stansca/f500-avionica/avionica_f500_v2/_revA_antiga/docs/pcb_top.png

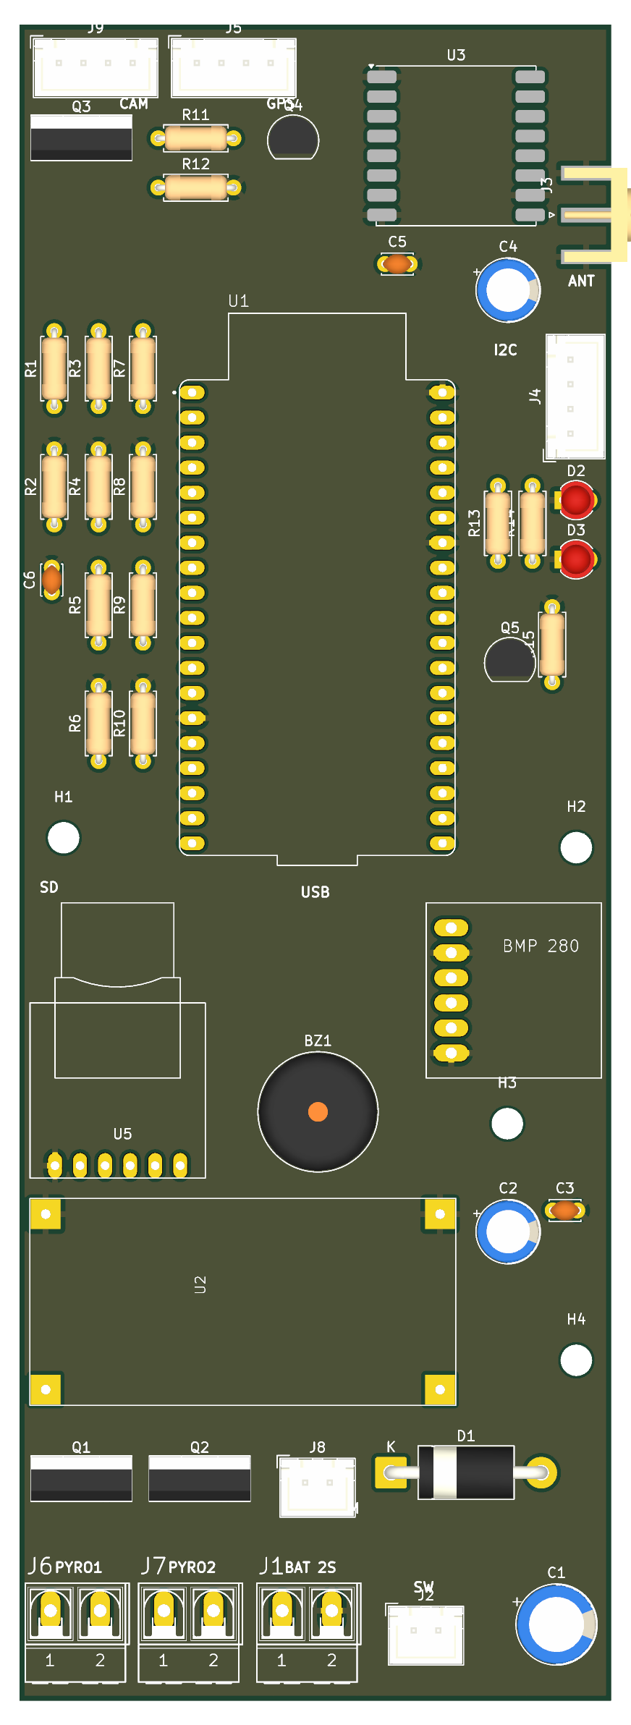
avionica_f500_v2/_revA_antiga/docs/pcb_top.png
