stansca/f500-avionica/avionica_f500_v2_sem_video/docs/pcb_bottom.png

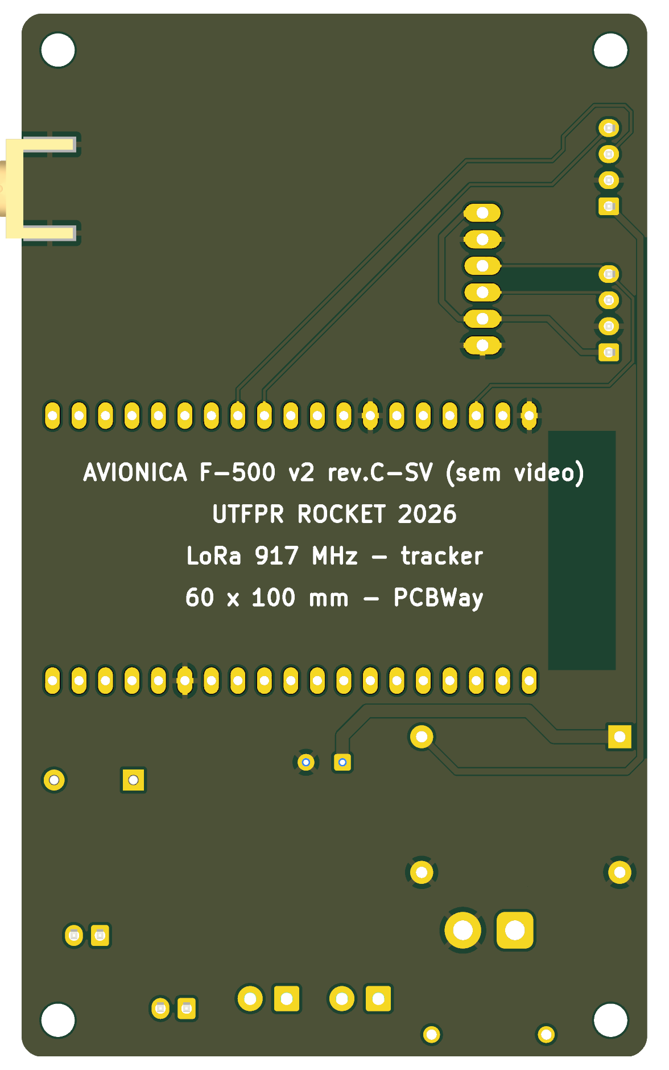
avionica_f500_v2_sem_video/docs/pcb_bottom.png
