stansca/f500-avionica/avionica_f500_v2/docs/BOM.csv

Reference | Value | Footprint | QUANTITY
BZ1 | Buzzer ativo 5V | Buzzer_Beeper:Buzzer_12x9.5RM7.6 | 1
C1 | 470uF 16V | Capacitor_THT:CP_Radial_D8.0mm_P3.50mm | 1
C2 | 10uF 25V | Capacitor_SMD:C_1206_3216Metric_Pad1.33x1.80mm_HandSolder | 1
C3 | 10uF | Capacitor_SMD:C_1206_3216Metric_Pad1.33x1.80mm_HandSolder | 1
C4-C7,C9,C11,C12,C14,C16 | 100nF | Capacitor_SMD:C_0805_2012Metric_Pad1.18x1.45mm_HandSolder | 9
C8,C13,C15 | 10uF | Capacitor_SMD:C_0805_2012Metric_Pad1.18x1.45mm_HandSolder | 3
C10 | 100uF 16V | Capacitor_SMD:CP_Elec_6.3x7.7 | 1
D1 | SS34 | Diode_SMD:D_SMA_Handsoldering | 1
D2 | LED verde | LED_SMD:LED_0805_2012Metric_Pad1.15x1.40mm_HandSolder | 1
D3 | LED vermelho | LED_SMD:LED_0805_2012Metric_Pad1.15x1.40mm_HandSolder | 1
J1 | XT30 BATERIA 2S | Connector_AMASS:AMASS_XT30PW-M_1x02_P2.50mm_Horizontal | 1
J2 | CHAVE PRINCIPAL | Connector_JST:JST_XH_B2B-XH-A_1x02_P2.50mm_Vertical | 1
J3 | SMA 50R | Connector_Coaxial:SMA_Amphenol_132289_EdgeMount | 1
J4 | CAMERA / VTX | Connector_JST:JST_XH_B4B-XH-A_1x04_P2.50mm_Vertical | 1
J5 | I2C / IMU extra | Connector_JST:JST_XH_B4B-XH-A_1x04_P2.50mm_Vertical | 1
J6 | GPS NEO-M8N (cabo) | Connector_JST:JST_XH_B4B-XH-A_1x04_P2.50mm_Vertical | 1
J7 | microSD Molex 104031 | Connector_Card:microSD_HC_Molex_104031-0811 | 1
J8 | CHAVE DE ARME | Connector_JST:JST_XH_B2B-XH-A_1x02_P2.50mm_Vertical | 1
J9 | PYRO 1 (apogeu) | TerminalBlock_Phoenix:TerminalBlock_Phoenix_PT-1,5-2-3.5-H_1x02_P3.50mm_Horizontal | 1
J10 | PYRO 2 (backup) | TerminalBlock_Phoenix:TerminalBlock_Phoenix_PT-1,5-2-3.5-H_1x02_P3.50mm_Horizontal | 1
Q1,Q2,Q4,Q5 | AO3400A | Package_TO_SOT_SMD:SOT-23 | 4
Q3 | AO3401A | Package_TO_SOT_SMD:SOT-23 | 1
R1,R11,R15 | 100k | Resistor_SMD:R_0805_2012Metric_Pad1.20x1.40mm_HandSolder | 3
R2,R12,R16 | 22k | Resistor_SMD:R_0805_2012Metric_Pad1.20x1.40mm_HandSolder | 3
R3-R8,R10,R14,R19 | 10k | Resistor_SMD:R_0805_2012Metric_Pad1.20x1.40mm_HandSolder | 9
R9,R13 | 100 | Resistor_SMD:R_0805_2012Metric_Pad1.20x1.40mm_HandSolder | 2
R17,R18 | 330 | Resistor_SMD:R_0805_2012Metric_Pad1.20x1.40mm_HandSolder | 2
U1 | ESP32-DevKitC-32E | JS_Microcontroladores:ESP32-DevKitC-32E | 1
U2 | MP1584EN 5V 3A | F500v2:MP1584_Modulo | 1
U3 | RFM95W 915 MHz | RF_Module:HOPERF_RFM9XW_SMD | 1
U4 | BMP280 (0x76) | JS_Sensores:BMP280_Modulo | 1
