stansca/f500-avionica/avionica_f500_v2/_revA_antiga/docs/BOM.csv

Reference | Value | Footprint | QUANTITY
BZ1 | Buzzer ativo 5V | Buzzer_Beeper:Buzzer_12x9.5RM7.6 | 1
C1 | 470uF 16V | Capacitor_THT:CP_Radial_D8.0mm_P3.50mm | 1
C2,C4 | 100uF 10V | Capacitor_THT:CP_Radial_D6.3mm_P2.50mm | 2
C3,C5,C6 | 100nF | Capacitor_THT:C_Disc_D3.0mm_W2.0mm_P2.50mm | 3
D1 | 1N5822 | Diode_THT:D_DO-201AD_P15.24mm_Horizontal | 1
D2 | LED verde | LED_THT:LED_D3.0mm | 1
D3 | LED vermelho | LED_THT:LED_D3.0mm | 1
J1 | BATERIA 2S (7,4 V) | JS_Conectores:Borne_AK500-2 | 1
J2 | CHAVE_PRINCIPAL | Connector_JST:JST_XH_B2B-XH-A_1x02_P2.50mm_Vertical | 1
J3 | SMA antena 915 MHz | Connector_Coaxial:SMA_Amphenol_132289_EdgeMount | 1
J4 | I2C / IMU extra | Connector_JST:JST_XH_B4B-XH-A_1x04_P2.50mm_Vertical | 1
J5 | GPS NEO-M8N (cabo) | Connector_JST:JST_XH_B4B-XH-A_1x04_P2.50mm_Vertical | 1
J6 | PYRO 1 (apogeu) | JS_Conectores:Borne_AK500-2 | 1
J7 | PYRO 2 (backup) | JS_Conectores:Borne_AK500-2 | 1
J8 | CHAVE_ARME | Connector_JST:JST_XH_B2B-XH-A_1x02_P2.50mm_Vertical | 1
J9 | CAMERA / VTX (DJI O4 / Walksnail) | Connector_JST:JST_XH_B4B-XH-A_1x04_P2.50mm_Vertical | 1
Q1,Q2 | IRLZ44N | Package_TO_SOT_THT:TO-220-3_Vertical | 2
Q3 | IRF9540N | Package_TO_SOT_THT:TO-220-3_Vertical | 1
Q4,Q5 | 2N7000 | Package_TO_SOT_THT:TO-92_Inline | 2
R1,R5,R9 | 100k | Resistor_THT:R_Axial_DIN0207_L6.3mm_D2.5mm_P7.62mm_Horizontal | 3
R2,R6,R10 | 22k | Resistor_THT:R_Axial_DIN0207_L6.3mm_D2.5mm_P7.62mm_Horizontal | 3
R3,R7 | 100 | Resistor_THT:R_Axial_DIN0207_L6.3mm_D2.5mm_P7.62mm_Horizontal | 2
R4,R8,R11,R12,R15 | 10k | Resistor_THT:R_Axial_DIN0207_L6.3mm_D2.5mm_P7.62mm_Horizontal | 5
R13,R14 | 330 | Resistor_THT:R_Axial_DIN0207_L6.3mm_D2.5mm_P7.62mm_Horizontal | 2
U1 | ESP32-DevKitC-32E | JS_Microcontroladores:ESP32-DevKitC-32E | 1
U2 | Buck LM2596 -> 5V | JS_Energia:Buck_Conversor | 1
U3 | RFM95W 915 MHz | RF_Module:HOPERF_RFM9XW_SMD | 1
U4 | BMP280 (0x76) | JS_Sensores:BMP280_Modulo | 1
U5 | Cartão microSD | JS_Modulos:SD_Card_Adapter | 1
