stansca/f500-avionica/avionica_f500_v2/docs/esquematico.pdf

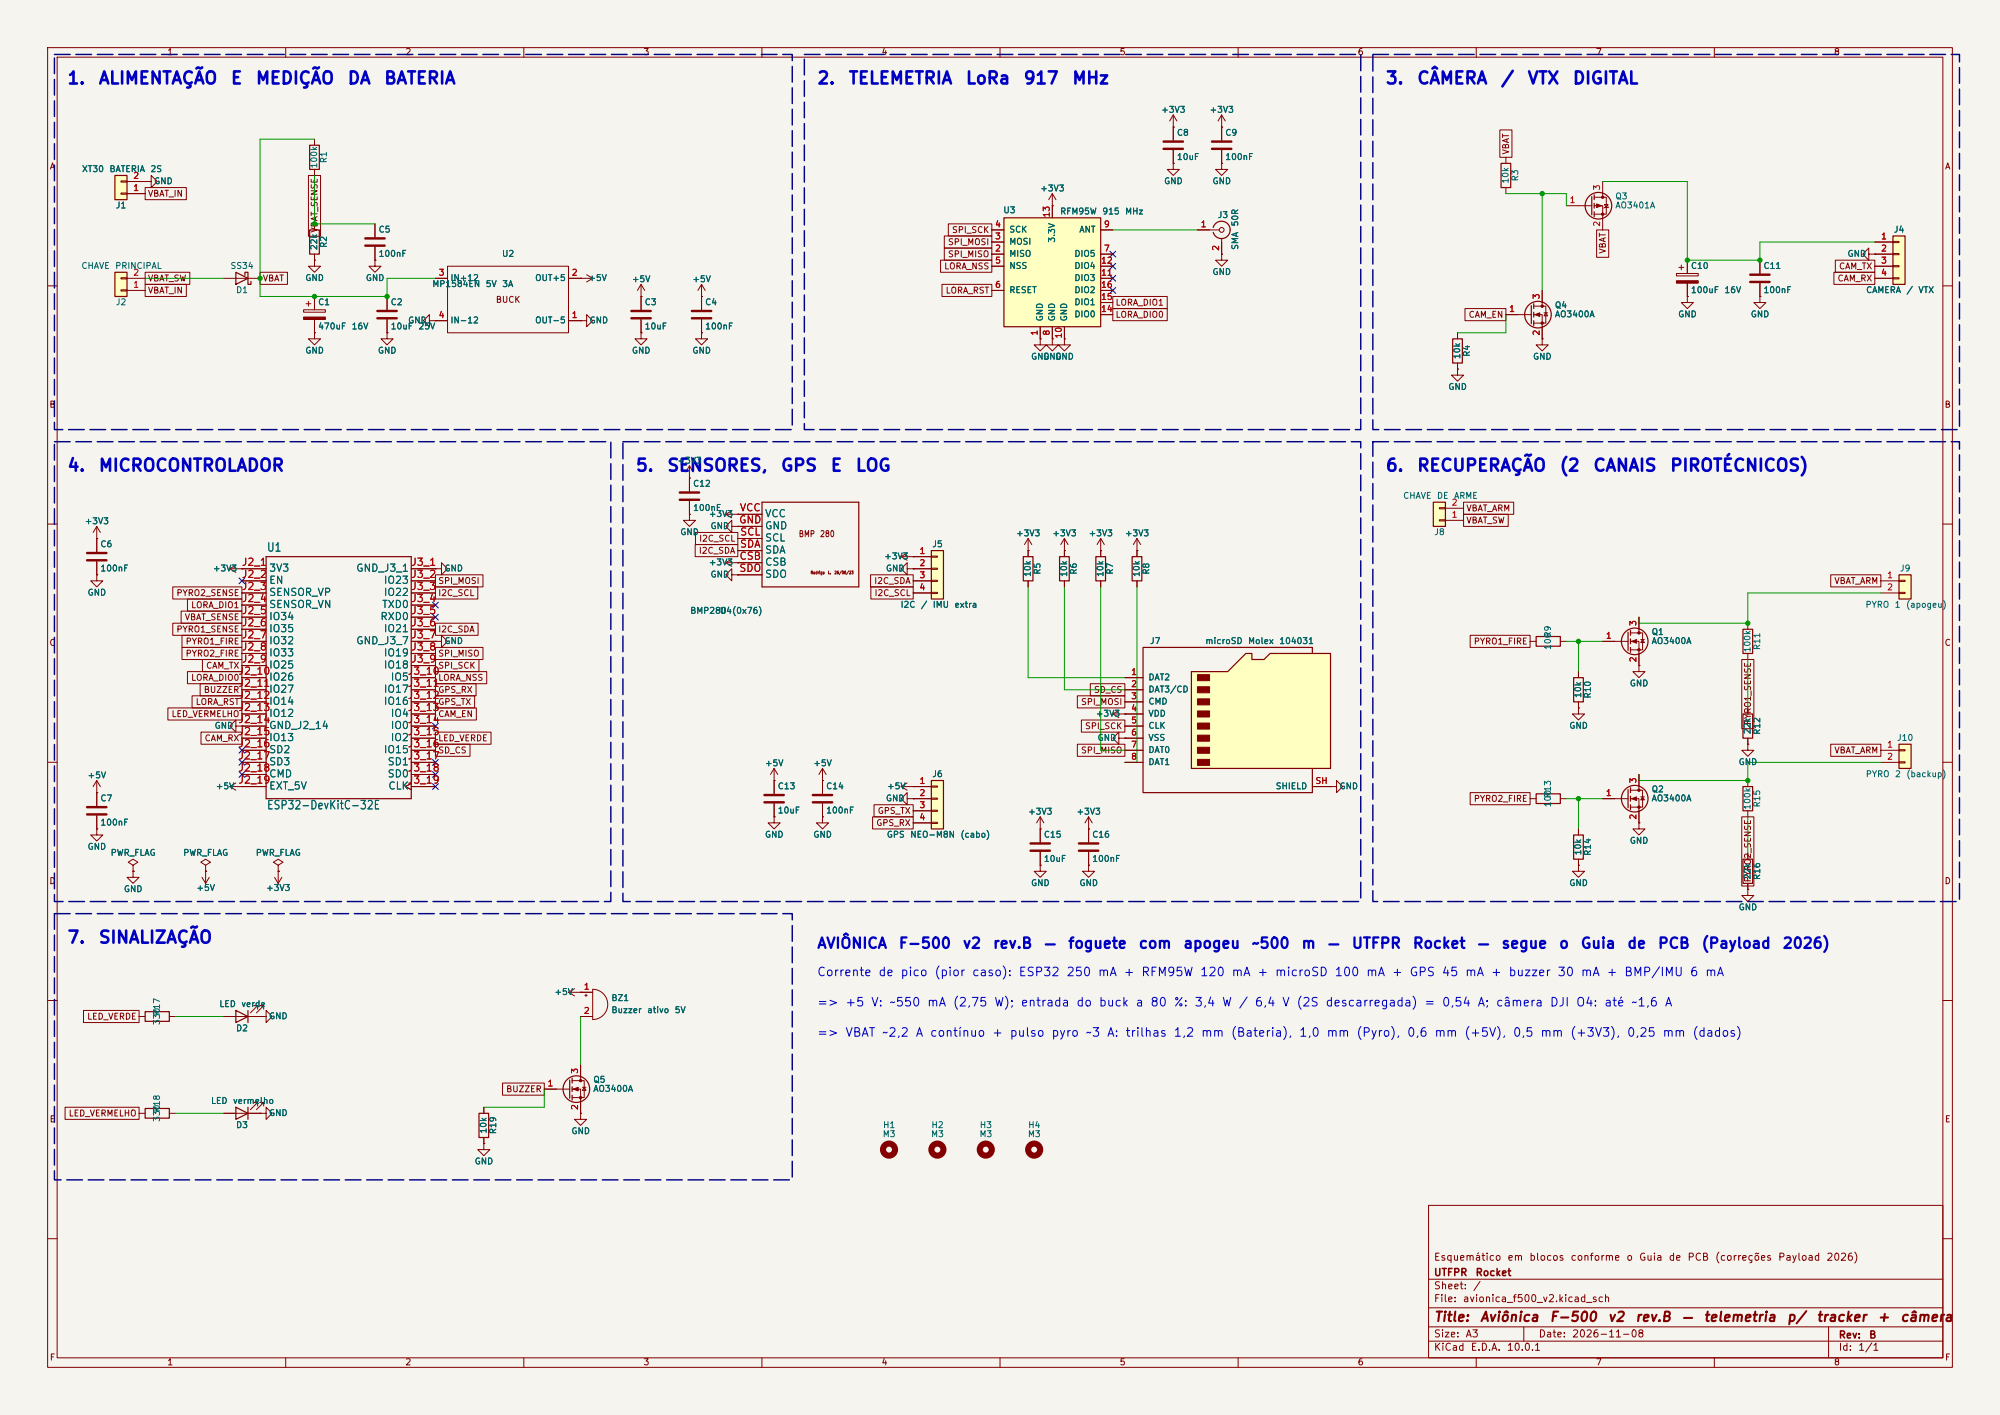
[picture p16: page 1]

6. RECUPERAÇÃO (2 CANAIS PIROTÉCNICOS) => VBAT ~2,2 A contínuo + pulso pyro ~3 A: trilhas 1,2 mm (Bateria), 1,0 mm (Pyro), 0,6 mm (+5V), 0,5 mm (+3V3), 0,25 mm (dados) => +5 V: ~550 mA (2,75 W); entrada do buck a 80 %: 3,4 W / 6,4 V (2S descarregada) = 0,54 A; câmera DJI O4: até ~1,6 A

AVIÔNICA F-500 v2 rev.B — foguete com apogeu ~500 m — UTFPR Rocket — segue o Guia de PCB (Payload 2026)

Corrente de pico (pior caso): ESP32 250 mA + RFM95W 120 mA + microSD 100 mA + GPS 45 mA + buzzer 30 mA + BMP/IMU 6 mA

Esquemático em blocos conforme o Guia de PCB (correções Payload 2026)
UTFPR Rocket
Sheet: /
File: avionica_f500_v2.kicad_sch
Title: Aviônica F-500 v2 rev.B — telemetria p/ tracker + câmera

Size: A3 | Rev: B | F Date: 2026-11-08
KiCad E.D.A. 10.0.1 | Id: 1/1
