stansca/f500-avionica/avionica_f500_v2_sem_video/docs/esquematico.pdf

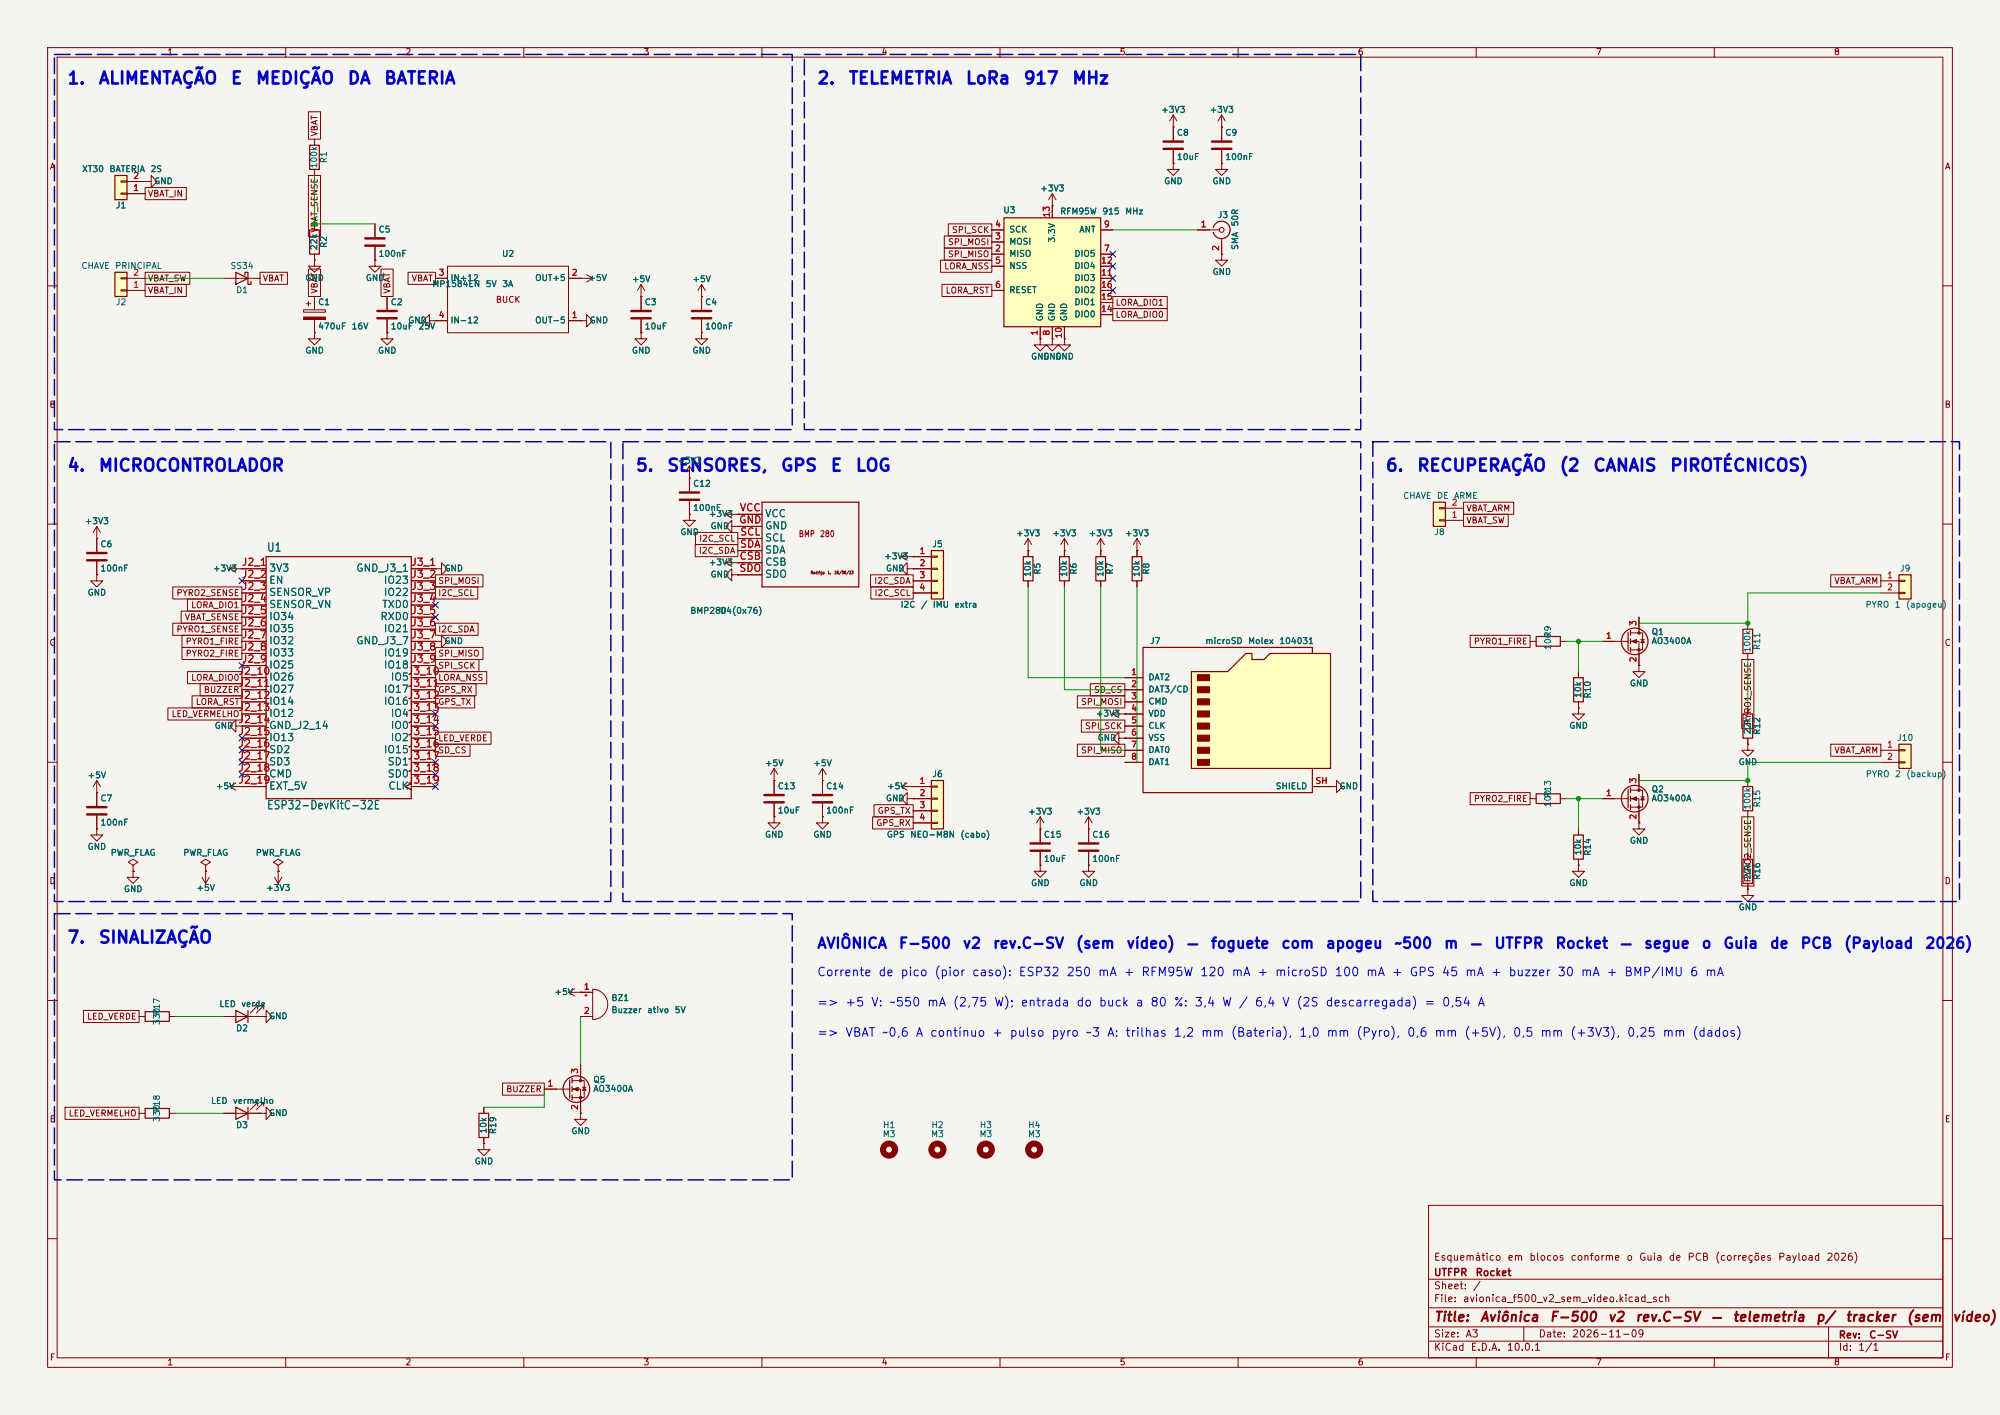
[picture p17: page 1]

1. ALIMENTAÇÃO E MEDIÇÃO DA BATERIA

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

Esquemático em blocos conforme o Guia de PCB (correções Payload 2026)
UTFPR Rocket
Sheet: /
File: avionica_f500_v2_sem_video.kicad_sch

Size: A3 | Rev: C-SV | F Date: 2026-11-09
KiCad E.D.A. 10.0.1 | Id: 1/1
