stansca/f500-avionica/avionica_f500_v2_video/docs/esquematico.pdf

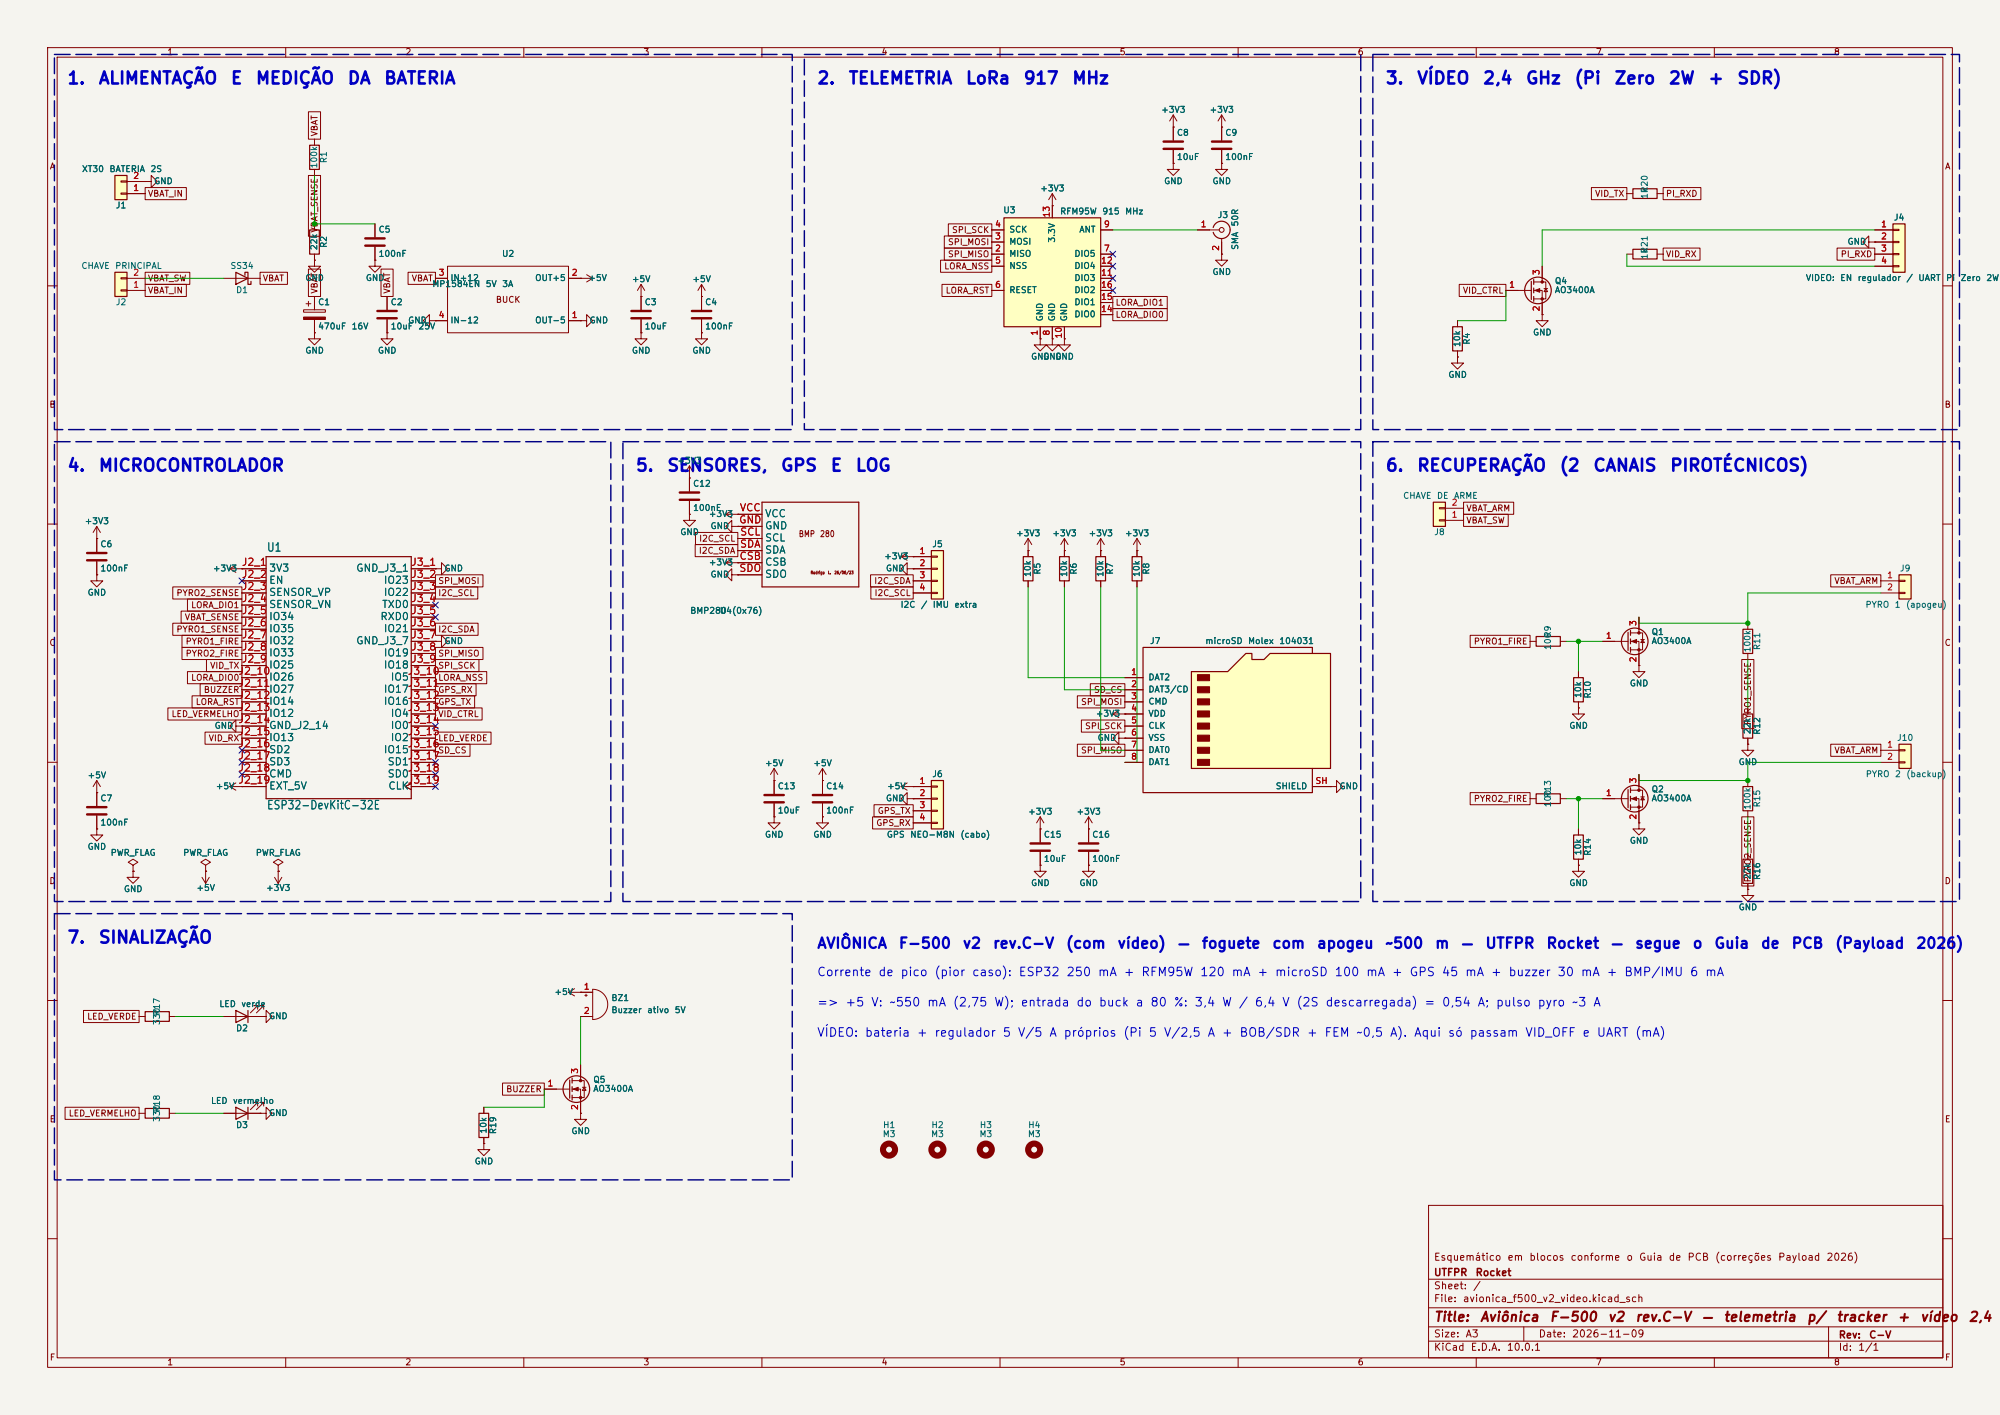
[picture p18: page 1]

1. ALIMENTAÇÃO E MEDIÇÃO DA BATERIA

3. VÍDEO 2,4 GHz (Pi Zero 2W + SDR)
Esquemático em blocos conforme o Guia de PCB (correções Payload 2026) R20 1k

AVIÔNICA F-500 v2 rev.C-V (com vídeo) — foguete com apogeu ~500 m — UTFPR Rocket — segue o Guia de PCB (Payload 2026)

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

VÍDEO: bateria + regulador 5 V/5 A próprios (Pi 5 V/2,5 A + BOB/SDR + FEM ~0,5 A). Aqui só passam VID_OFF e UART (mA) => +5 V: ~550 mA (2,75 W); entrada do buck a 80 %: 3,4 W / 6,4 V (2S descarregada) = 0,54 A; pulso pyro ~3 A

UTFPR Rocket
Sheet: /
File: avionica_f500_v2_video.kicad_sch
Title: Aviônica F-500 v2 rev.C-V — telemetria p/ tracker + vídeo 2,4 GHz

Size: A3 | Rev: C-V | F Date: 2026-11-09
KiCad E.D.A. 10.0.1 | Id: 1/1
