stansca/f500-avionica/avionica_f500_v2/_revA_antiga/docs/esquematico.pdf

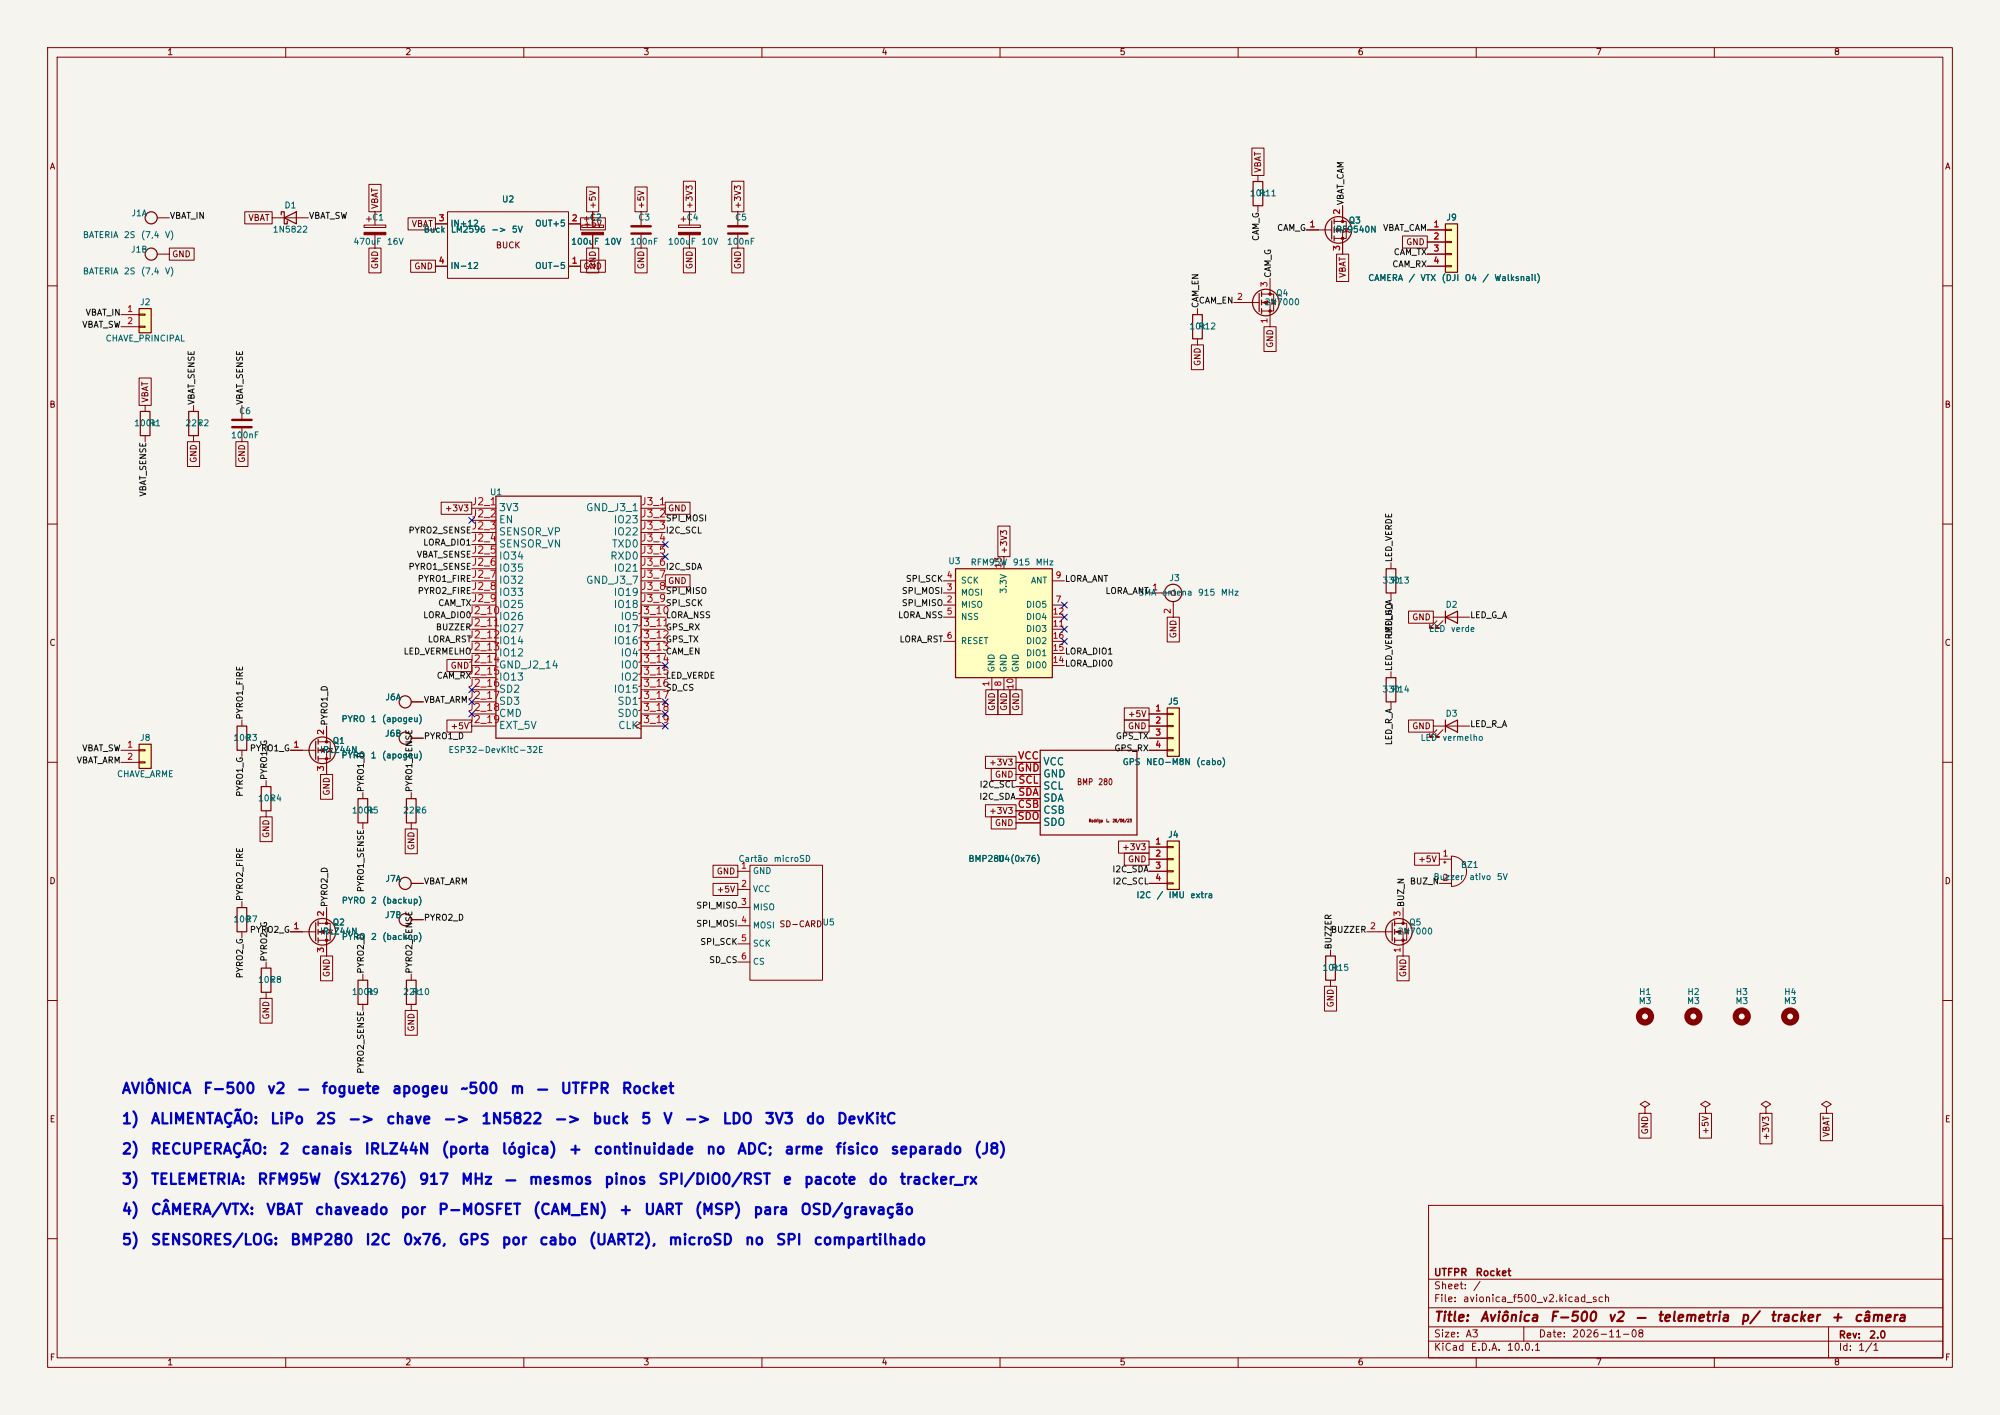
[picture p19: page 1]

J9 CAMERA / VTX (DJI O4 / Walksnail) 1
VBAT_CAM

AVIÔNICA F-500 v2 — foguete apogeu ~500 m — UTFPR Rocket
1) ALIMENTAÇÃO: LiPo 2S -> chave -> 1N5822 -> buck 5 V -> LDO 3V3 do DevKitC
2) RECUPERAÇÃO: 2 canais IRLZ44N (porta lógica) + continuidade no ADC; arme físico separado (J8)

3) TELEMETRIA: RFM95W (SX1276) 917 MHz — mesmos pinos SPI/DIO0/RST e pacote do tracker_rx
4) CÂMERA/VTX: VBAT chaveado por P-MOSFET (CAM_EN) + UART (MSP) para OSD/gravação

5) SENSORES/LOG: BMP280 I2C 0x76, GPS por cabo (UART2), microSD no SPI compartilhado

UTFPR Rocket
Sheet: /
File: avionica_f500_v2.kicad_sch
Title: Aviônica F-500 v2 — telemetria p/ tracker + câmera

Size: A3 | Rev: 2.0 | F Date: 2026-11-08
KiCad E.D.A. 10.0.1 | Id: 1/1
