stansca/f500-avionica/avionica_f500_v2_video/avionica_f500_v2_video.kicad_pcb

## KiCad design avionica_f500_v2_video/avionica_f500_v2_video.kicad_pcb (2026-11-14)

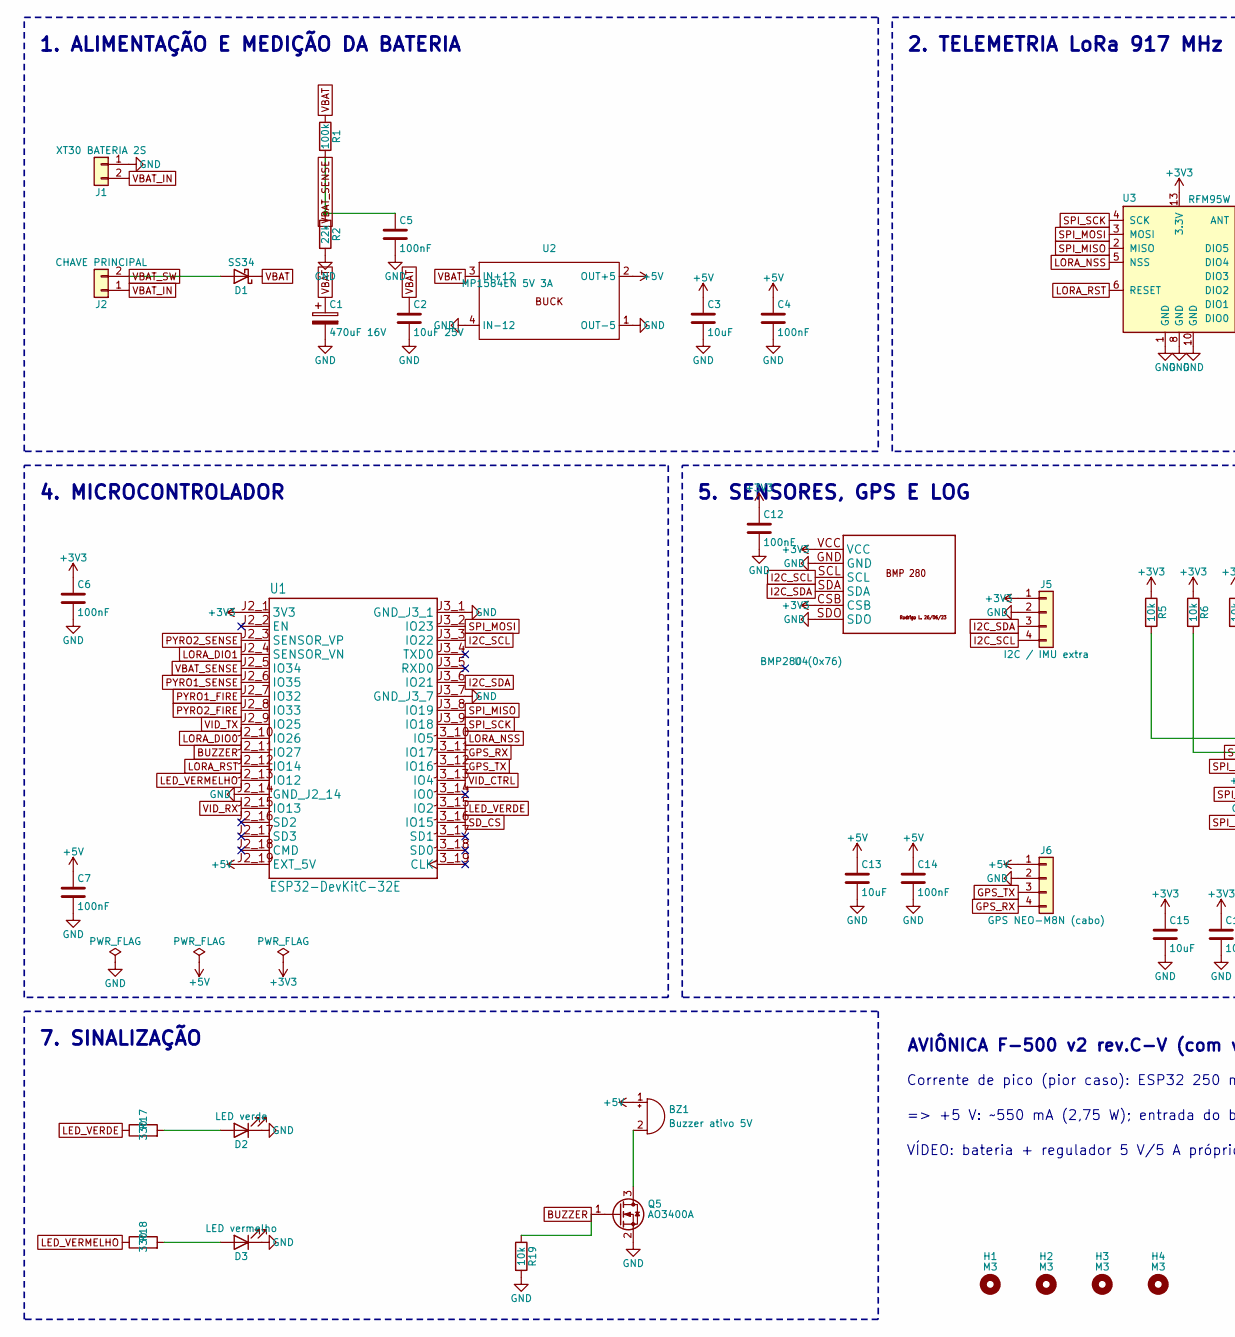
[picture p20: schematic avionica_f500_v2_video.kicad_sch, Aviônica F-500 v2 rev.C-V — telemetria p/ tracker + vídeo 2…, part in row 1, column 1]

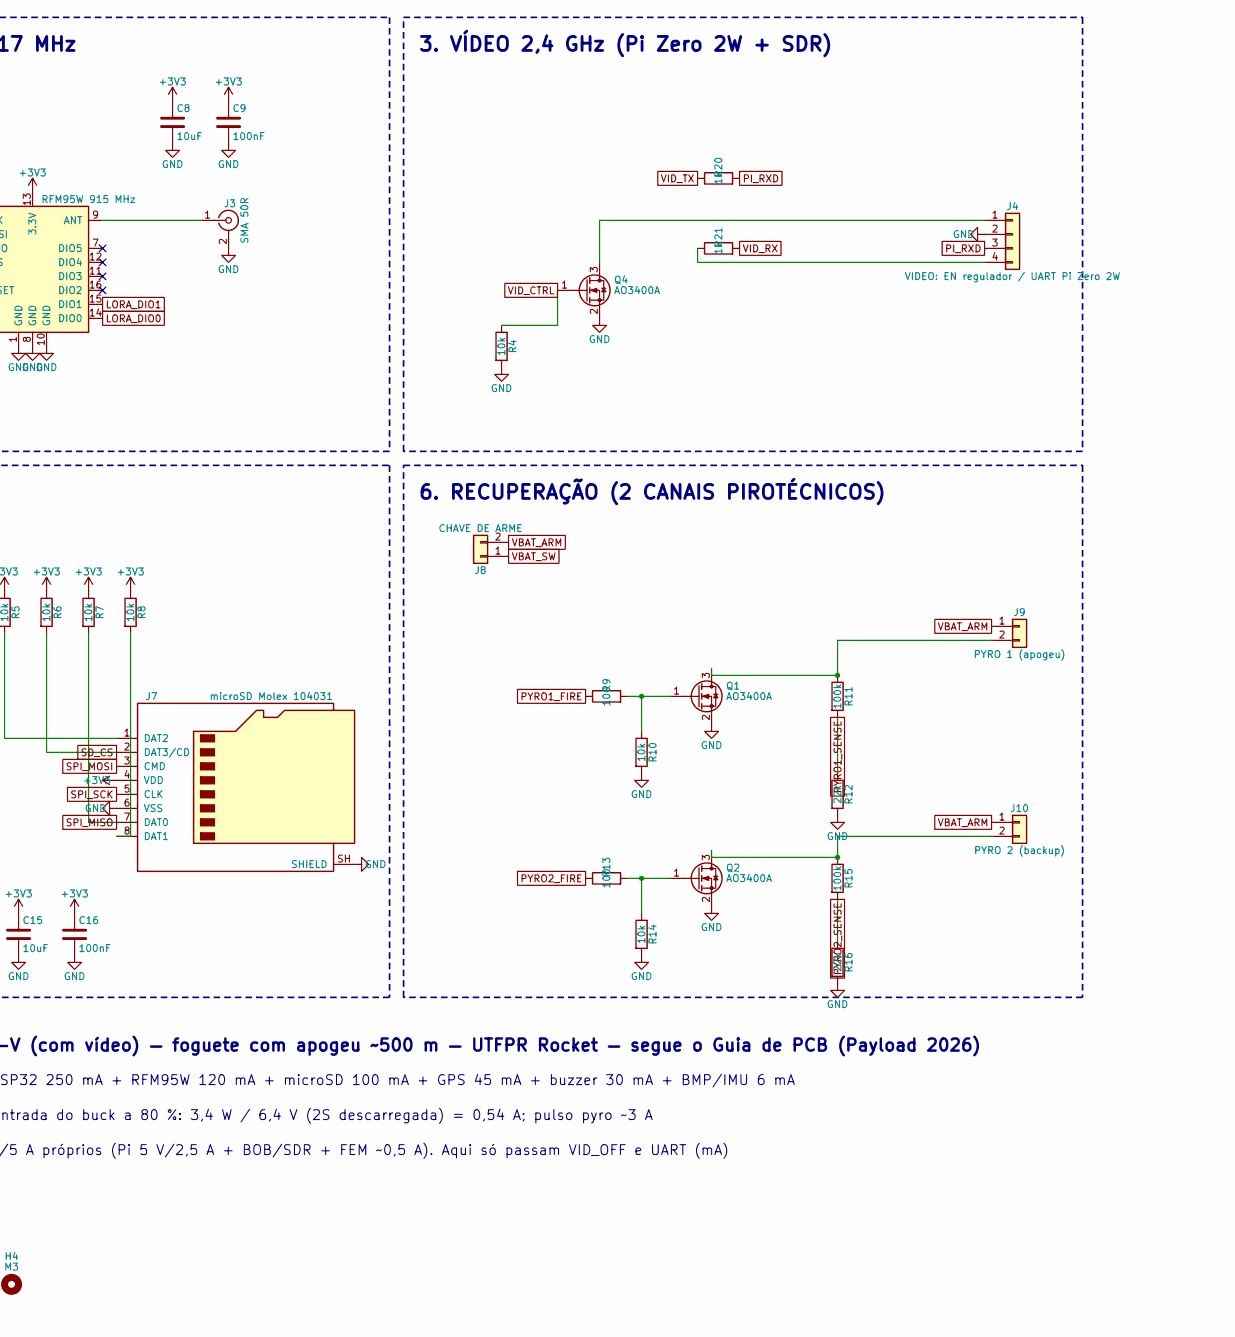
[picture p21: schematic avionica_f500_v2_video.kicad_sch, Aviônica F-500 v2 rev.C-V — telemetria p/ tracker + vídeo 2…, part in row 1, column 2]

Parts:
BZ1: Buzzer ativo 5V; Buzzer_12x9.5RM7.6
C1: 470uF 16V; CP_Radial_D8.0mm_P3.50mm
C2: 10uF 25V; C_1206_3216Metric_Pad1.33x1.80mm_HandSolder
C3: 10uF; C_1206_3216Metric_Pad1.33x1.80mm_HandSolder
C4, C5, C6, C7, C9, C12, C14, C16: 100nF; C_0805_2012Metric_Pad1.18x1.45mm_HandSolder
C8, C13, C15: 10uF; C_0805_2012Metric_Pad1.18x1.45mm_HandSolder
D1: SS34; D_SMA_Handsoldering
D2: LED verde; LED_0805_2012Metric_Pad1.15x1.40mm_HandSolder
D3: LED vermelho; LED_0805_2012Metric_Pad1.15x1.40mm_HandSolder
H1, H2, H3, H4: M3; MountingHole_3.2mm_M3
J1: XT30 BATERIA 2S; AMASS_XT30PW-M_1x02_P2.50mm_Horizontal
J2: CHAVE PRINCIPAL; JST_XH_B2B-XH-A_1x02_P2.50mm_Vertical
J3: SMA 50R; SMA_Amphenol_132289_EdgeMount
J4: VIDEO: EN regulador / UART Pi Zero 2W; JST_XH_B4B-XH-A_1x04_P2.50mm_Vertical
J5: I2C / IMU extra; JST_XH_B4B-XH-A_1x04_P2.50mm_Vertical
J6: GPS NEO-M8N (cabo); JST_XH_B4B-XH-A_1x04_P2.50mm_Vertical
J7: microSD Molex 104031; microSD_HC_Molex_104031-0811
J8: CHAVE DE ARME; JST_XH_B2B-XH-A_1x02_P2.50mm_Vertical
J9: PYRO 1 (apogeu); TerminalBlock_Phoenix_PT-1,5-2-3.5-H_1x02_P3.50mm_Horizontal
J10: PYRO 2 (backup); TerminalBlock_Phoenix_PT-1,5-2-3.5-H_1x02_P3.50mm_Horizontal
Q1, Q2, Q4, Q5: AO3400A; SOT-23
R1, R11, R15: 100k; R_0805_2012Metric_Pad1.20x1.40mm_HandSolder
R2, R12, R16: 22k; R_0805_2012Metric_Pad1.20x1.40mm_HandSolder
R4, R5, R6, R7, R8, R10, R14, R19: 10k; R_0805_2012Metric_Pad1.20x1.40mm_HandSolder
R9, R13: 100; R_0805_2012Metric_Pad1.20x1.40mm_HandSolder
R17, R18: 330; R_0805_2012Metric_Pad1.20x1.40mm_HandSolder
R20, R21: 1k; R_0805_2012Metric_Pad1.20x1.40mm_HandSolder
U1: ESP32-DevKitC-32E
U2: MP1584EN 5V 3A; MP1584_Modulo
U3: RFM95W 915 MHz; HOPERF_RFM9XW_SMD
U4: BMP280 (0x76); BMP280_Modulo

Connections:
+3V3: C6.1, C8.1, C9.1, C12.1, C15.1, C16.1, J5.1, J7.4 (VDD), R5.1, R6.1, R7.1, R8.1, U1.J2_1 (3V3), U3.13 (3.3V), U4.CSB, U4.VCC
+5V: BZ1.1 (+), C3.1, C4.1, C7.1, C13.1, C14.1, J6.1, U1.J2_19 (EXT_5V), U2.2 (OUT+5)
BUZZER: Q5.1 (G), R19.1, U1.J2_11 (IO27)
GND: C1.2, C2.2, C3.2, C4.2, C5.2, C6.2, C7.2, C8.2, C9.2, C12.2, C13.2, C14.2, C15.2, C16.2, D2.1 (K), D3.1 (K), J1.1, J3.2 (Ext), J4.2, J5.2, J6.2, J7.6 (VSS), J7.SH (SHIELD), Q1.2 (S), Q2.2 (S), Q4.2 (S), Q5.2 (S), R2.2, R4.2, R10.2, R12.2, R14.2, R16.2, R19.2, U1.J2_14 (GND_J2_14), U1.J3_1 (GND_J3_1), U1.J3_7 (GND_J3_7), U2.1 (OUT-5), U2.4 (IN-12), U3.1 (GND), U3.8 (GND), U3.10 (GND), U4.GND, U4.SDO
GPS_RX: J6.4, U1.J3_11 (IO17)
GPS_TX: J6.3, U1.J3_12 (IO16)
I2C_SCL: J5.4, U1.J3_3 (IO22), U4.SCL
I2C_SDA: J5.3, U1.J3_6 (IO21), U4.SDA
LED_VERDE: R17.1, U1.J3_15 (IO2)
LED_VERMELHO: R18.1, U1.J2_13 (IO12)
LORA_DIO0: U1.J2_10 (IO26), U3.14 (DIO0)
LORA_DIO1: U1.J2_4 (SENSOR_VN), U3.15 (DIO1)
LORA_NSS: U1.J3_10 (IO5), U3.5 (NSS)
LORA_RST: U1.J2_12 (IO14), U3.6 (RESET)
unnamed: BZ1.2 (-), Q5.3 (D)
unnamed: D2.2 (A), R17.2
unnamed: D3.2 (A), R18.2
unnamed: J3.1 (In), U3.9 (ANT)
unnamed: J4.1, Q4.3 (D)
unnamed: J4.4, R21.1
unnamed: J7.8 (DAT1), R8.2
unnamed: J7.1 (DAT2), R5.2
unnamed: J9.2, Q1.3 (D), R11.1
unnamed: J10.2, Q2.3 (D), R15.1
unnamed: Q1.1 (G), R9.2, R10.1
unnamed: Q2.1 (G), R13.2, R14.1
PI_RXD: J4.3, R20.2
PYRO1_FIRE: R9.1, U1.J2_7 (IO32)
PYRO1_SENSE: R11.2, R12.1, U1.J2_6 (IO35)
PYRO2_FIRE: R13.1, U1.J2_8 (IO33)
PYRO2_SENSE: R15.2, R16.1, U1.J2_3 (SENSOR_VP)
SD_CS: J7.2 (DAT3/CD), R6.2, U1.J3_16 (IO15)
SPI_MISO: J7.7 (DAT0), R7.2, U1.J3_8 (IO19), U3.2 (MISO)
SPI_MOSI: J7.3 (CMD), U1.J3_2 (IO23), U3.3 (MOSI)
SPI_SCK: J7.5 (CLK), U1.J3_9 (IO18), U3.4 (SCK)
VBAT: C1.1, C2.1, D1.1 (K), R1.1, U2.3 (IN+12)
VBAT_ARM: J8.2, J9.1, J10.1
VBAT_IN: J1.2, J2.1
VBAT_SENSE: C5.1, R1.2, R2.1, U1.J2_5 (IO34)
VBAT_SW: D1.2 (A), J2.2, J8.1
VID_CTRL: Q4.1 (G), R4.1, U1.J3_13 (IO4)
VID_RX: R21.2, U1.J2_15 (IO13)
VID_TX: R20.1, U1.J2_9 (IO25)

Notes on the sheet:
1. ALIMENTAÇÃO E MEDIÇÃO DA BATERIA
2. TELEMETRIA LoRa 917 MHz
3. VÍDEO 2,4 GHz (Pi Zero 2W + SDR)
4. MICROCONTROLADOR
5. SENSORES, GPS E LOG
6. RECUPERAÇÃO (2 CANAIS PIROTÉCNICOS)
7. SINALIZAÇÃO
AVIÔNICA F-500 v2 rev.C-V (com vídeo) — foguete com apogeu ~500 m — UTFPR Rocket — segue o Guia de PCB (Payload 2026)
Corrente de pico (pior caso): ESP32 250 mA + RFM95W 120 mA + microSD 100 mA + GPS 45 mA + buzzer 30 mA + BMP/IMU 6 mA
=> +5 V: ~550 mA (2,75 W); entrada do buck a 80 %: 3,4 W / 6,4 V (2S descarregada) = 0,54 A; pulso pyro ~3 A
VÍDEO: bateria + regulador 5 V/5 A próprios (Pi 5 V/2,5 A + BOB/SDR + FEM ~0,5 A). Aqui só passam VID_OFF e UART (mA)

Board: 2 copper layers, 60 parts (0 on the bottom side), 43 nets, no tracks yet.
