stansca/f500-avionica/avionica_f500_v2/_revA_antiga/avionica_f500_v2.kicad_pcb

## KiCad design avionica_f500_v2/_revA_antiga/avionica_f500_v2.kicad_pcb (2026-11-10)

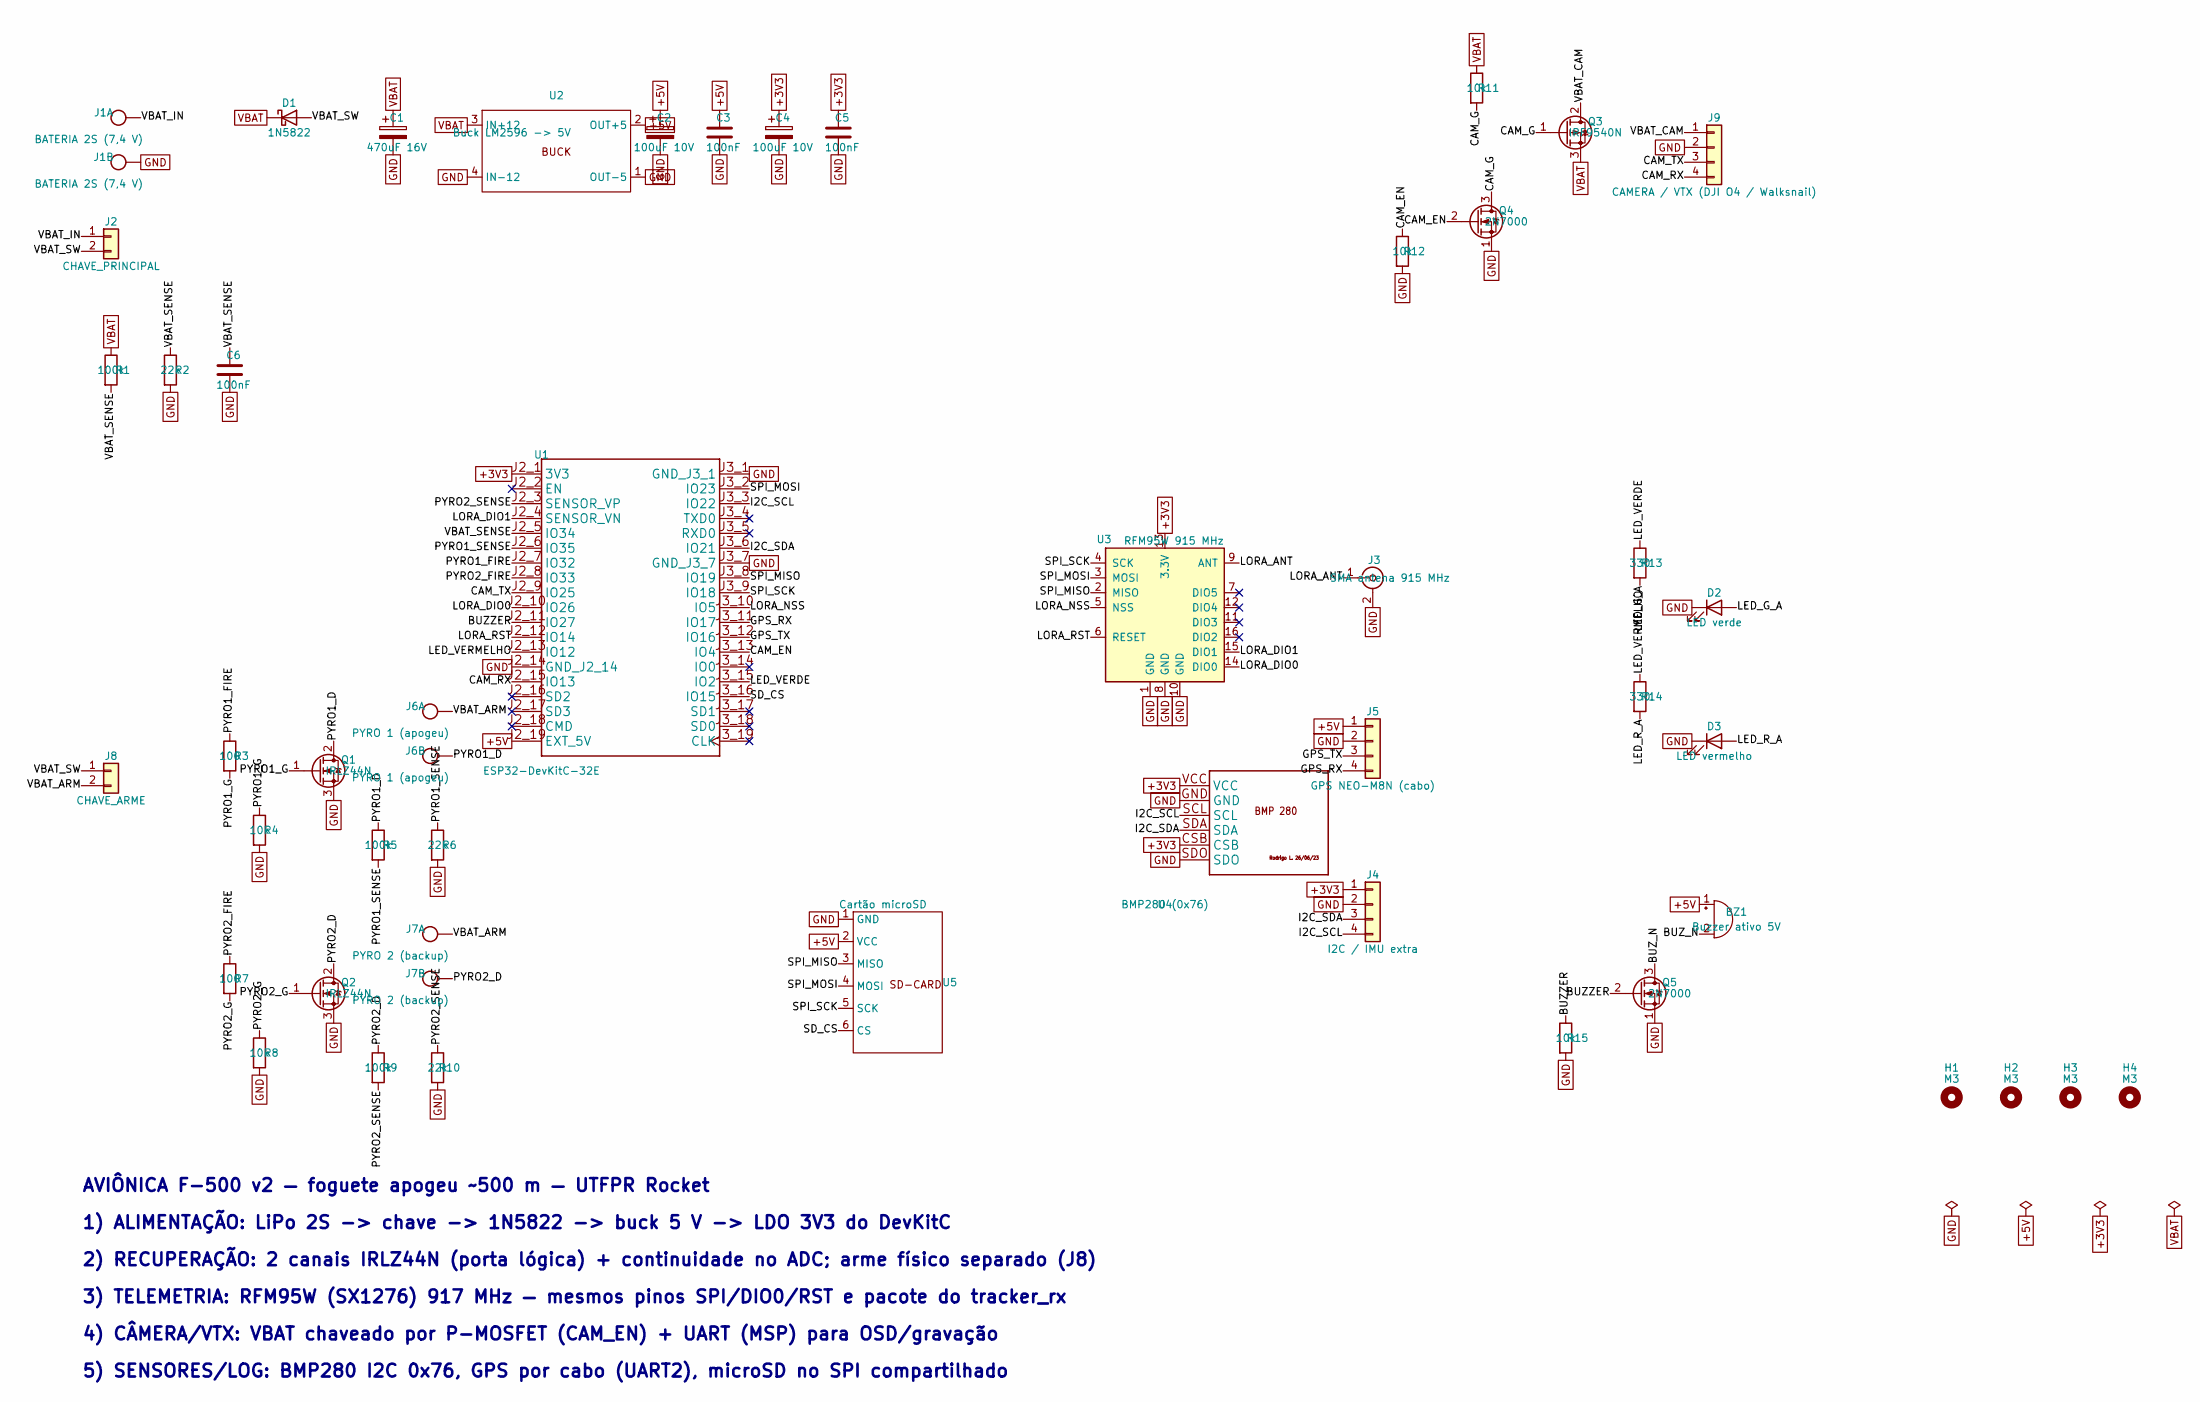
[picture p22: schematic avionica_f500_v2.kicad_sch, Aviônica F-500 v2 — telemetria p/ tracker + câmera]

Parts:
BZ1: Buzzer ativo 5V; Buzzer_12x9.5RM7.6
C1: 470uF 16V; CP_Radial_D8.0mm_P3.50mm
C2, C4: 100uF 10V; CP_Radial_D6.3mm_P2.50mm
C3, C5, C6: 100nF; C_Disc_D3.0mm_W2.0mm_P2.50mm
D1: 1N5822; D_DO-201AD_P15.24mm_Horizontal
D2: LED verde; LED_D3.0mm
D3: LED vermelho; LED_D3.0mm
H1, H2, H3, H4: M3; MountingHole_3.2mm_M3
J1: BATERIA 2S (7,4 V); Borne_AK500-2
J2: CHAVE_PRINCIPAL; JST_XH_B2B-XH-A_1x02_P2.50mm_Vertical
J3: SMA antena 915 MHz; SMA_Amphenol_132289_EdgeMount
J4: I2C / IMU extra; JST_XH_B4B-XH-A_1x04_P2.50mm_Vertical
J5: GPS NEO-M8N (cabo); JST_XH_B4B-XH-A_1x04_P2.50mm_Vertical
J6: PYRO 1 (apogeu); Borne_AK500-2
J7: PYRO 2 (backup); Borne_AK500-2
J8: CHAVE_ARME; JST_XH_B2B-XH-A_1x02_P2.50mm_Vertical
J9: CAMERA / VTX (DJI O4 / Walksnail); JST_XH_B4B-XH-A_1x04_P2.50mm_Vertical
Q1, Q2: IRLZ44N; TO-220-3_Vertical
Q3: IRF9540N; TO-220-3_Vertical
Q4, Q5: 2N7000; TO-92_Inline
R1, R5, R9: 100k; R_Axial_DIN0207_L6.3mm_D2.5mm_P7.62mm_Horizontal
R2, R6, R10: 22k; R_Axial_DIN0207_L6.3mm_D2.5mm_P7.62mm_Horizontal
R3, R7: 100; R_Axial_DIN0207_L6.3mm_D2.5mm_P7.62mm_Horizontal
R4, R8, R11, R12, R15: 10k; R_Axial_DIN0207_L6.3mm_D2.5mm_P7.62mm_Horizontal
R13, R14: 330; R_Axial_DIN0207_L6.3mm_D2.5mm_P7.62mm_Horizontal
U1: ESP32-DevKitC-32E
U2: Buck LM2596 -> 5V; Buck_Conversor
U3: RFM95W 915 MHz; HOPERF_RFM9XW_SMD
U4: BMP280 (0x76); BMP280_Modulo
U5: Cartão microSD; SD_Card_Adapter

Connections:
+3V3: C4.1, C5.1, J4.1, U1.J2_1 (3V3), U3.13 (3.3V), U4.CSB, U4.VCC
+5V: BZ1.1 (+), C2.1, C3.1, J5.1, U1.J2_19 (EXT_5V), U2.2 (OUT+5), U5.2 (VCC)
/BUZZER: Q5.2 (G), R15.1, U1.J2_11 (IO27)
/BUZ_N: BZ1.2 (-), Q5.3 (D)
/CAM_EN: Q4.2 (G), R12.1, U1.J3_13 (IO4)
/CAM_G: Q3.1 (G), Q4.3 (D), R11.2
/CAM_RX: J9.4, U1.J2_15 (IO13)
/CAM_TX: J9.3, U1.J2_9 (IO25)
/GPS_RX: J5.4, U1.J3_11 (IO17)
/GPS_TX: J5.3, U1.J3_12 (IO16)
/I2C_SCL: J4.4, U1.J3_3 (IO22), U4.SCL
/I2C_SDA: J4.3, U1.J3_6 (IO21), U4.SDA
/LED_G_A: D2.2 (A), R13.2
/LED_R_A: D3.2 (A), R14.2
/LED_VERDE: R13.1, U1.J3_15 (IO2)
/LED_VERMELHO: R14.1, U1.J2_13 (IO12)
/LORA_ANT: J3.1 (In), U3.9 (ANT)
/LORA_DIO0: U1.J2_10 (IO26), U3.14 (DIO0)
/LORA_DIO1: U1.J2_4 (SENSOR_VN), U3.15 (DIO1)
/LORA_NSS: U1.J3_10 (IO5), U3.5 (NSS)
/LORA_RST: U1.J2_12 (IO14), U3.6 (RESET)
/PYRO1_D: J6.2, Q1.2 (D), R5.1
/PYRO1_FIRE: R3.1, U1.J2_7 (IO32)
/PYRO1_G: Q1.1 (G), R3.2, R4.1
/PYRO1_SENSE: R5.2, R6.1, U1.J2_6 (IO35)
/PYRO2_D: J7.2, Q2.2 (D), R9.1
/PYRO2_FIRE: R7.1, U1.J2_8 (IO33)
/PYRO2_G: Q2.1 (G), R7.2, R8.1
/PYRO2_SENSE: R9.2, R10.1, U1.J2_3 (SENSOR_VP)
/SD_CS: U1.J3_16 (IO15), U5.6 (CS)
/SPI_MISO: U1.J3_8 (IO19), U3.2 (MISO), U5.3 (MISO)
/SPI_MOSI: U1.J3_2 (IO23), U3.3 (MOSI), U5.4 (MOSI)
/SPI_SCK: U1.J3_9 (IO18), U3.4 (SCK), U5.5 (SCK)
/VBAT_ARM: J6.1, J7.1, J8.2
/VBAT_CAM: J9.1, Q3.2 (D)
/VBAT_IN: J1.1, J2.1
/VBAT_SENSE: C6.1, R1.2, R2.1, U1.J2_5 (IO34)
/VBAT_SW: D1.2 (A), J2.2, J8.1
GND: C1.2, C2.2, C3.2, C4.2, C5.2, C6.2, D2.1 (K), D3.1 (K), J1.2, J3.2 (Ext), J4.2, J5.2, J9.2, Q1.3 (S), Q2.3 (S), Q4.1 (S), Q5.1 (S), R2.2, R4.2, R6.2, R8.2, R10.2, R12.2, R15.2, U1.J2_14 (GND_J2_14), U1.J3_1 (GND_J3_1), U1.J3_7 (GND_J3_7), U2.1 (OUT-5), U2.4 (IN-12), U3.1 (GND), U3.8 (GND), U3.10 (GND), U4.GND, U4.SDO, U5.1 (GND)
VBAT: C1.1, D1.1 (K), Q3.3 (S), R1.1, R11.1, U2.3 (IN+12)

Notes on the sheet:
AVIÔNICA F-500 v2 — foguete apogeu ~500 m — UTFPR Rocket
1) ALIMENTAÇÃO: LiPo 2S -> chave -> 1N5822 -> buck 5 V -> LDO 3V3 do DevKitC
2) RECUPERAÇÃO: 2 canais IRLZ44N (porta lógica) + continuidade no ADC; arme físico separado (J8)
3) TELEMETRIA: RFM95W (SX1276) 917 MHz — mesmos pinos SPI/DIO0/RST e pacote do tracker_rx
4) CÂMERA/VTX: VBAT chaveado por P-MOSFET (CAM_EN) + UART (MSP) para OSD/gravação
5) SENSORES/LOG: BMP280 I2C 0x76, GPS por cabo (UART2), microSD no SPI compartilhado

Board: 2 copper layers, 48 parts (0 on the bottom side), 40 nets, no tracks yet.
