stansca/f500-avionica/rayquasa/pcb_Avionica_F-500.kicad_pcb

## KiCad design rayquasa/pcb_Avionica_F-500.kicad_pcb (2026-11-10)

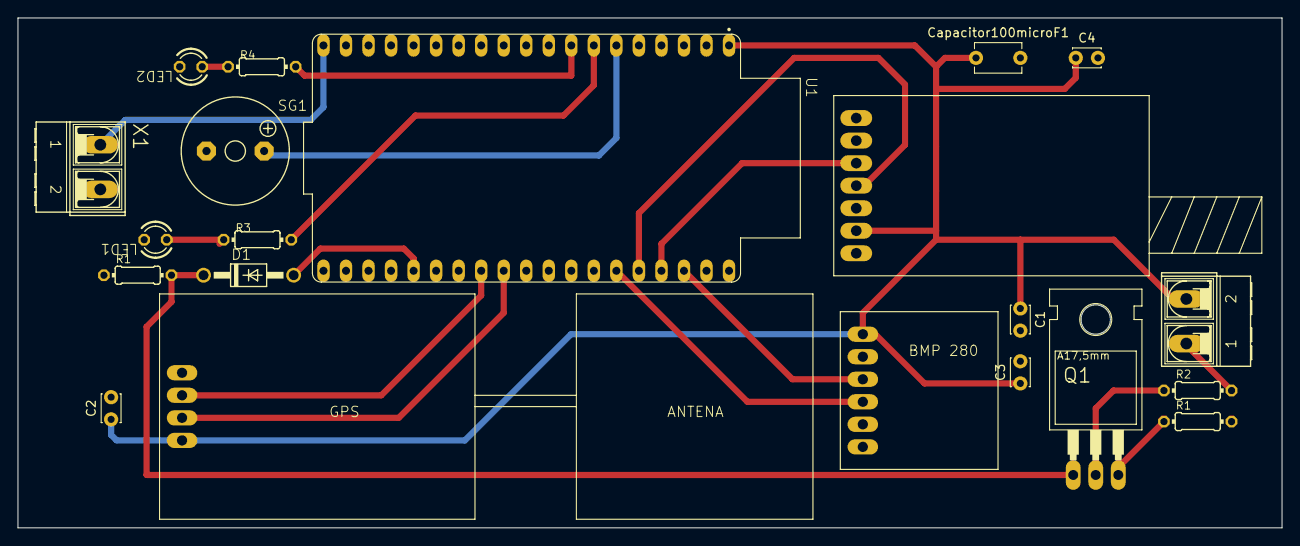
[picture p23: board pcb_Avionica_F-500.kicad_pcb from above]

Board: 2 copper layers, 142.5 x 57.5 mm, 21 parts (0 on the bottom side), 19 nets.

Parts:
C1, C2, C3, C4: C_Small; C_Disc_D3.0mm_W2.0mm_P2.50mm
Capacitor100microF1: C; C_Disc_D5.1mm_W3.2mm_P5.00mm
D1: 1N4004; DO41-10
LED1, LED2: TLLR4400; LED_3mm
Q1: IRF620; TO220
R1, R1#2, R2, R3, R4: R_Axial_0204-7
SG1: F/QMX; Buzzer_F-QMX
U1: ESP32-DevKitC-32E
U$1: BMP280; BMP280_Modulo
U$2: GPS; GPS_NEO-M8N
U$3: LORAE32; LoRa_E32
X1, X2: Borne_AK500-2

Connections:
3.3V: C1.1, C2.1, C3.1, C4.1, Capacitor100microF1.1, U1.J2_1, U$1.VCC, U$2.5V, U$3.5V, X2.2
ACIONA: D1.A, U1.J3_15
BUZZER: SG1.+, U1.J2_6
EXT_5V: U1.J2_19, X1.1
GND: C1.2, C2.2, C3.2, C4.2, Capacitor100microF1.2, LED1.K, LED2.K, R1.1, R1#2.2, SG1.-, U1.J2_14, U1.J3_1, U1.J3_7, U$1.GND, U$2.GND, U$3.GND, X1.2
L_VERDE: R3.2, U1.J2_7
L_VERMELHO: R4.2, U1.J2_8
unnamed: D1.C, Q1.1, R1.2
unnamed: Q1.2, R2.1
unnamed: LED1.A, R3.1
unnamed: LED2.A, R4.1
RX-GPS: U1.J3_11, U$2.RX
RX-LORA: U1.J3_4, U$3.RX
SCL: U1.J3_3, U$1.SCL
SDA: U1.J3_6, U$1.SDA
SKIB: R2.2, X2.1
Source: Q1.3, R1#2.1
TX-GPS: U1.J3_12, U$2.TX
TX-LORA: U1.J3_5, U$3.TX
