stansca/f500-avionica/avionica_f500_v2/scripts/pcb_pos.py

# Posições na PCB 60 x 100 mm (y para baixo; topo = ogiva)
# (x0, y0, rot) -> canto sup-esq do bbox rotacionado | ("pad1", x, y, rot) | ("c", x, y, rot) -> origem do footprint
P = {
    # furos M3 nos cantos
    "H1": ("c", 3.5, 3.5, 0), "H2": ("c", 56.5, 3.5, 0), "H3": ("c", 3.5, 96.5, 0), "H4": ("c", 56.5, 96.5, 0),
    # --- topo: LoRa (longe do buck) ---
    "U3": (33.5, 1.5, 0), "J3": ("pad1", 57.3, 16.8, 0), "C8": (43.0, 19.0, 0), "C9": (47.0, 19.0, 0),
    # --- câmera ---
    "J4": (8.0, 0.8, 0), "C10": (8.5, 8.5, 0), "C11": (18.5, 9.2, 0), "Q3": (23.0, 8.6, 0), "R3": (28.0, 9.2, 0),
    "Q4": (23.0, 12.8, 0), "R4": (28.0, 13.4, 0),
    # --- sensores / GPS / SD ---
    "J6": (0.8, 8.0, 90), "C13": (8.5, 17.0, 90), "C14": (11.0, 17.0, 90),
    "J5": (0.8, 22.0, 90),
    "U4": (13.0, 16.5, 0), "C12": (31.5, 17.0, 90),
    "J7": (43.5, 22.8, 90), "R5": (34.0, 22.0, 90), "R6": (36.5, 22.0, 90), "R7": (39.0, 22.0, 90), "R8": (41.5, 22.0, 90),
    "C15": (34.0, 28.5, 90), "C16": (37.0, 28.5, 90),
    # --- microcontrolador (USB para a borda direita) ---
    "U1": (3.0, 37.0, 90), "C6": (8.5, 47.0, 90), "C7": (50.0, 47.0, 90),
    # embaixo do DevKit (só SMD baixo): divisor da bateria, sinalização
    "R1": (12.0, 47.0, 90), "R2": (14.5, 47.0, 90), "C5": (17.0, 47.0, 90),
    "R17": (22.0, 47.0, 90), "R18": (24.5, 47.0, 90), "R19": (29.0, 47.0, 90), "Q5": (31.5, 47.5, 0),
    # --- alimentação (embaixo, longe do LoRa) ---
    "U2": (0.8, 67.0, 0), "C3": (23.8, 68.0, 90), "C4": (23.8, 74.0, 90),
    "C1": (26.5, 67.5, 0), "D1": (36.0, 68.0, 0), "C2": (36.5, 72.5, 0),
    "J1": (8.0, 85.6, 180), "J2": (49.5, 85.5, 0),
    # --- sinalização visível ---
    "BZ1": (46.8, 67.2, 0), "D2": (47.0, 81.0, 0), "D3": (51.5, 81.0, 0),
    # --- recuperação ---
    "J9": (23.5, 90.8, 0), "J10": (32.3, 90.8, 0), "J8": (41.2, 92.5, 0),
    "Q1": (24.0, 78.0, 0), "R9": (28.5, 78.3, 0), "R10": (24.0, 82.0, 90), "R11": (33.0, 78.3, 0), "R12": (27.0, 82.0, 90),
    "Q2": (37.5, 78.0, 0), "R13": (41.5, 78.3, 0), "R14": (37.5, 82.0, 90), "R15": (33.0, 81.5, 0), "R16": (40.0, 82.0, 90),
}
