stansca/f500-avionica/(commit log)

2026-11-10 Versão inicial: Aviônica do foguete F-500 (UTFPR Rocket): v1 e v2 (rev. B, C-V com vídeo, C-SV sem vídeo) em KiCad 10, firmware de teste e documentação
    [BOM.csv, avionica_f500_v2.kicad_pcb, avionica_f500_v2.kicad_sch, avionica_f500_v2_sem_video.kicad_pcb, avionica_f500_v2_sem_video.kicad_sch, avionica_f500_v2_video.kicad_pcb, avionica_f500_v2_video.kicad_sch, pcb_Avionica_F-500.kicad_pcb]
2026-11-14 Rev. C-V: roteamento refeito do zero, guia de roteamento e netclasses de RF/pyro corrigidas
    - Roteamento antigo da rev. C-V apagado (diagonais longas cortando os planos de GND,
    GPS no B.Cu embaixo do RFM95W, 1 via só, antena sem rotear). Posicionamento mantido.
    - docs/GUIA_ROTEAMENTO.md: ordem de roteamento com as coordenadas dos pinos
    (antena -> potência -> pyros -> +5V/+3V3 -> LoRa -> GPS/I2C -> vídeo -> costura de GND).
    - Netclasses nas 3 variantes: redes de 2 pinos viram Net-(Ref-Pino) no esquemático gerado,
    então a antena (Net-(J3-In)) e os drenos dos pyros (Net-(J9-Pin_2), Net-(J10-Pin_2))
    caíam na Default de 0,25 mm. Agora entram em RF_50ohm (2,8 mm) e Pyro (1,0 mm).
    [avionica_f500_v2_video.kicad_pcb]
2026-11-14 Rev. C-V: polaridade do XT30 corrigida (pad 1 = GND, pad 2 = VBAT_IN)
    O footprint AMASS do KiCad marca o pad 1 do XT30 como "-", mas a placa ligava VBAT_IN
    no pad 1. Com a bateria invertida, o diodo interno dos MOSFETs dos pyros poderia conduzir
    do GND para o VBAT_ARM e disparar o ignitor ao fechar o arme.
    - Esquemático: símbolo do J1 espelhado (fios e rótulos inalterados).
    - PCB: redes dos pads do J1 trocadas, zonas de GND preenchidas de novo. Paridade 0.
    - design.py atualizado para gerações futuras.
    A rev. B e a rev. C-SV continuam com o erro (têm trilhas).
    [avionica_f500_v2_video.kicad_pcb, avionica_f500_v2_video.kicad_sch]
